AInitikesh/MapMirror/case/stl/fit_test_mount.stl

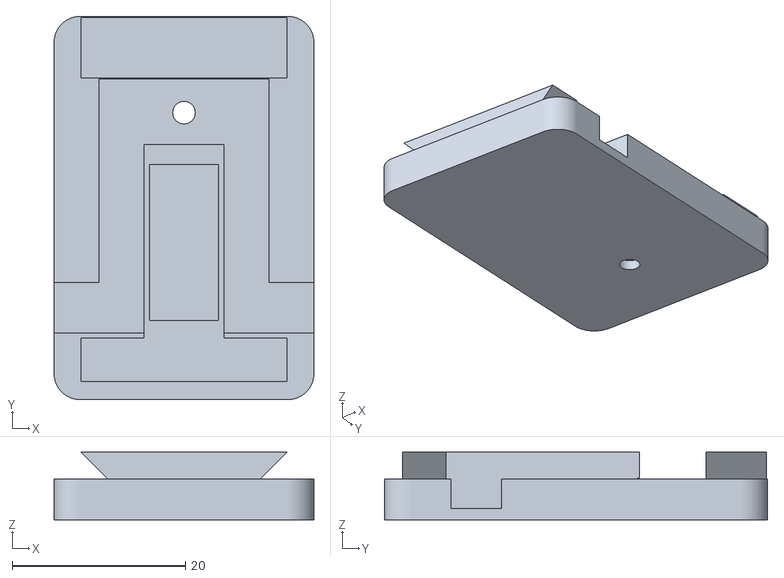
[picture p13: CAD file, 2026-11-09]
case/stl/fit_test_mount.stl
30.0 x 44.2 x 7.80
