AInitikesh/MapMirror/case/stl/mount_upper.stl

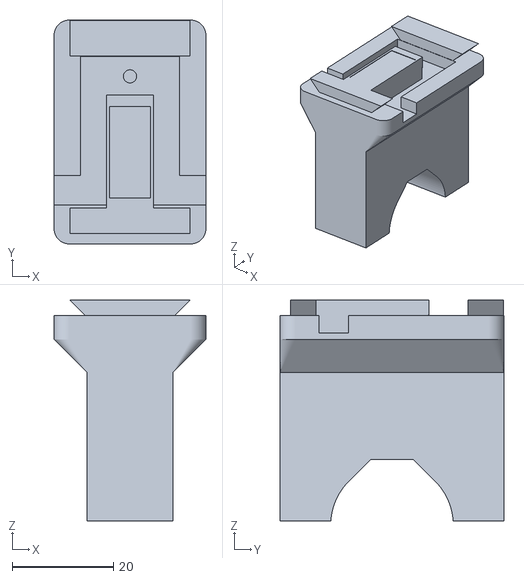
[picture p14: CAD file, 2026-11-09]
case/stl/mount_upper.stl
30.0 x 44.2 x 43.7
