AInitikesh/MapMirror/case/stl/mount_lower.stl

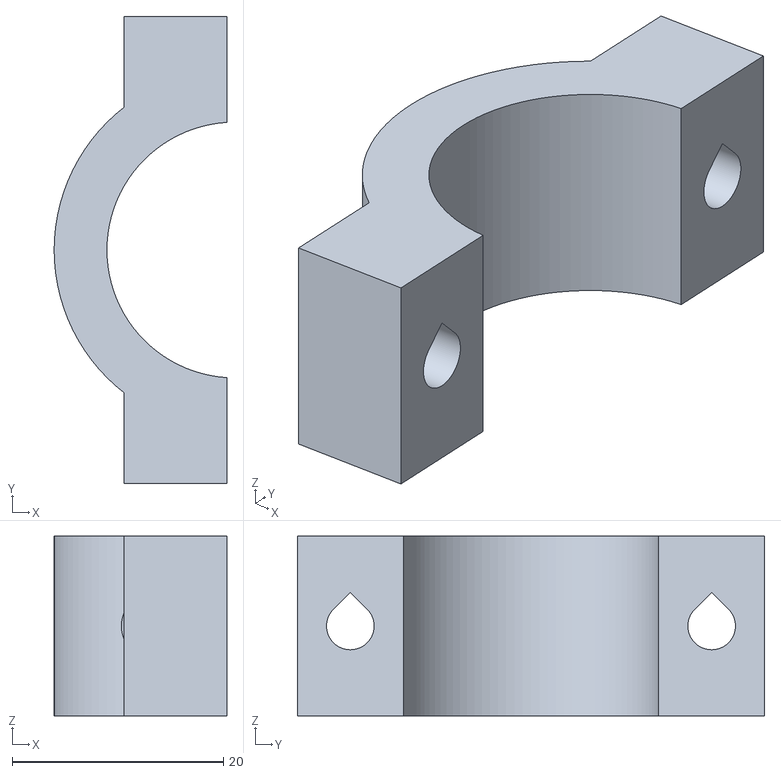
[picture p15: CAD file, 2026-11-09]
case/stl/mount_lower.stl
16.4 x 44.2 x 17.0
