AInitikesh/MapMirror/case/stl/box_lid.stl

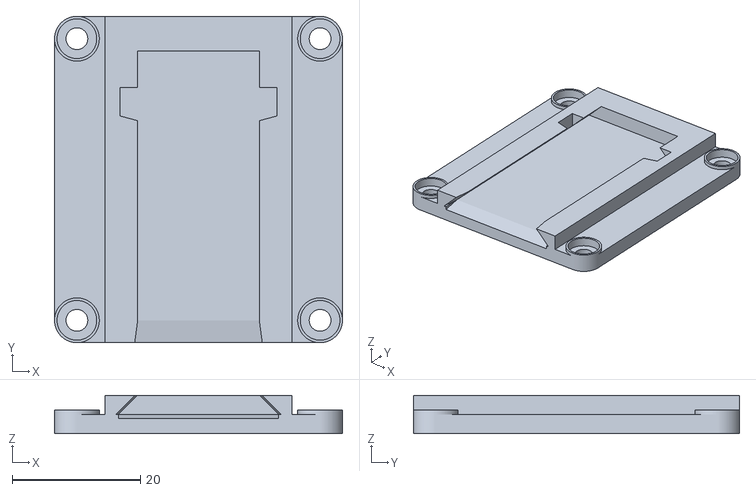
[picture p16: CAD file, 2026-11-07]
case/stl/box_lid.stl
45.0 x 51.0 x 6.00
