AInitikesh/MapMirror/case/stl/fit_test_bracket.stl

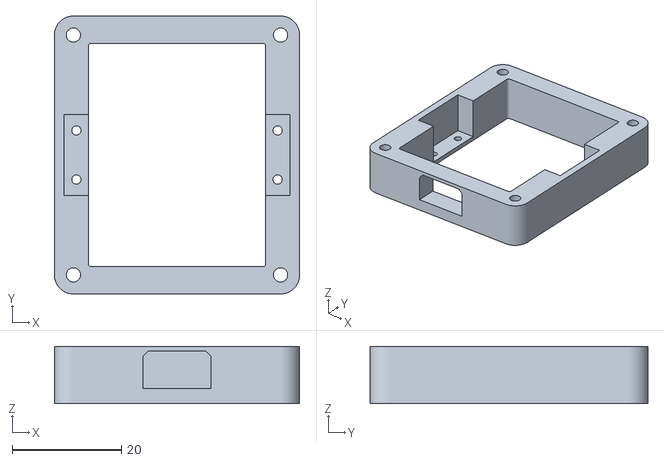
[picture p17: CAD file, 2026-11-07]
case/stl/fit_test_bracket.stl
45.0 x 51.0 x 10.5
