AInitikesh/MapMirror/case/stl/fit_test_front.stl

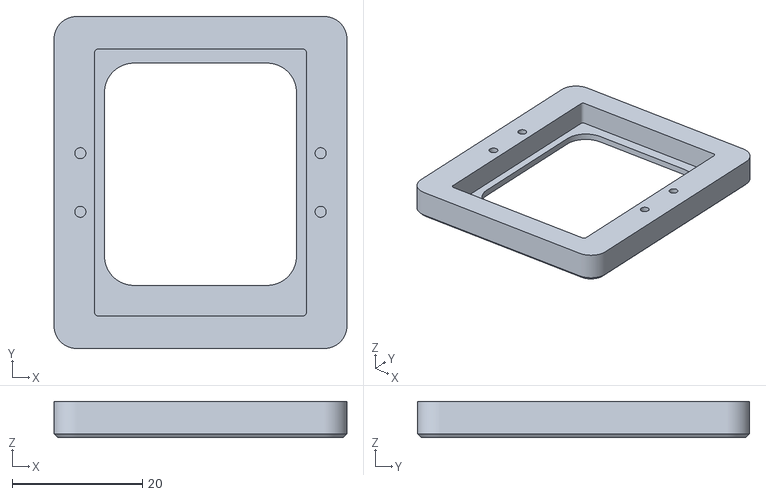
[picture p18: CAD file, 2026-11-07]
case/stl/fit_test_front.stl
45.0 x 51.0 x 5.60
