AInitikesh/MapMirror/case/stl/display_bracket.stl

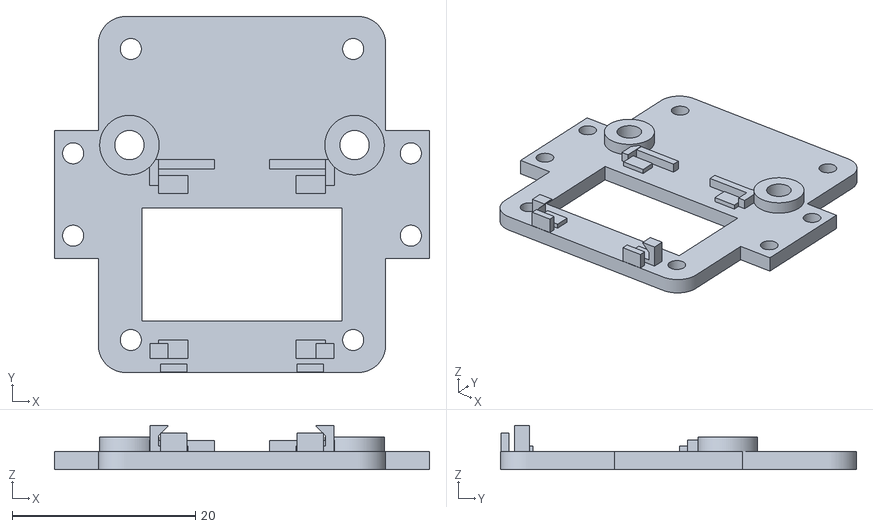
[picture p19: CAD file, 2026-11-07]
case/stl/display_bracket.stl
41.0 x 38.9 x 4.85
