AInitikesh/MapMirror/case/stl/latch.stl

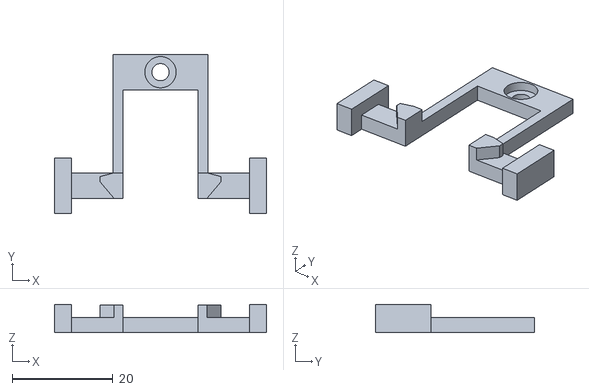
[picture p20: CAD file, 2026-11-07]
case/stl/latch.stl
42.0 x 31.5 x 5.60
