AInitikesh/MapMirror/case/stl/xiao_strap.stl

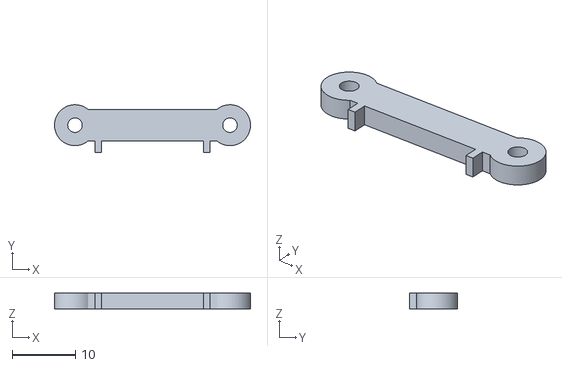
[picture p21: CAD file, 2026-11-07]
case/stl/xiao_strap.stl
31.1 x 7.55 x 2.50
