AInitikesh/MapMirror/case/stl/front_shell.stl

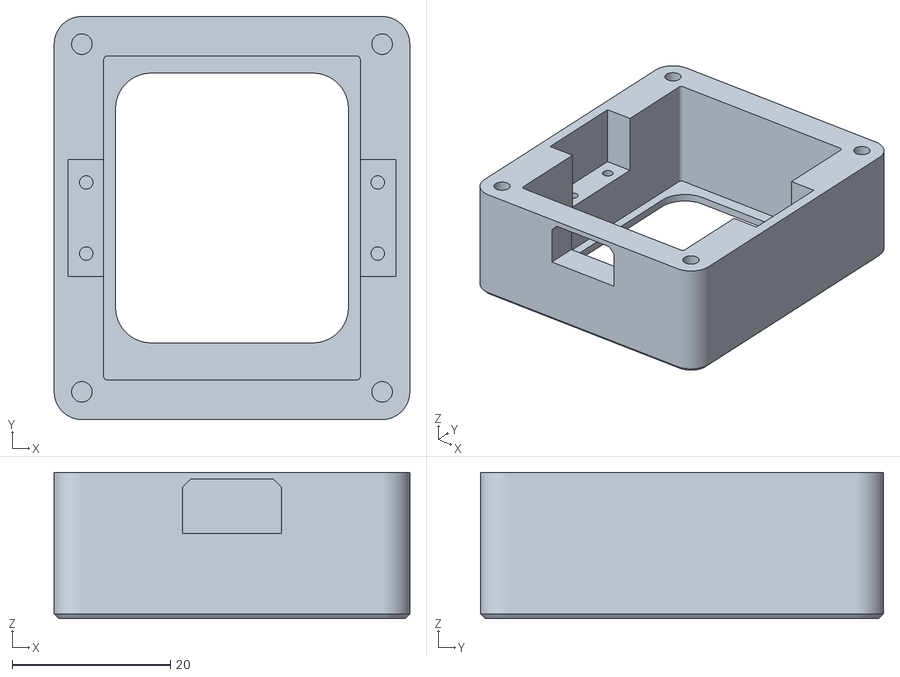
[picture p22: CAD file, 2026-11-07]
case/stl/front_shell.stl
45.0 x 51.0 x 18.5
