AInitikesh/MapMirror/(commit log)

2026-11-07 Add MapMirror: mirror your phone's screen to a handlebar display
    An Android app mirrors your phone's screen, such as your navigation app, to a
    240x280 ST7789 display driven by an ESP32, over Wi-Fi or Bluetooth LE. It can
    also run the navigation app on a private virtual display, so the phone stays
    free for other apps.
    - android/: the phone app. Each display's key is confirmed once with a code
    shown on both, then checked on every connection, and Wi-Fi frames are
    encrypted with AES-128-GCM.
    - firmware/: the ESP32 firmware, with a pairing window for new phones.
    - case/: a 3D printable, screwed-shut handlebar case with a quick release,
    generated and checked by build.py.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
    [box_lid.stl, display_bracket.stl, fit_test_bracket.stl, fit_test_front.stl, fit_test_mount.stl, front_shell.stl, latch.stl, mount_lower.stl]
2026-11-09 Fit the clip-on mount to a Karizma XMR, tap its screws, start the display service on Wi-Fi
    Case:
    - SIDE_H sets the switch block's height above the bar; the build sizes the
    upper mount's neck from it and checks the plate and box clear it.
    - Clamp narrowed from 22 to 17 mm to fit between the clutch and switch block.
    - Upper mount bolts and the latch screw tap into pilot holes, no inserts.
    App:
    - Starts the display service in the background while on Wi-Fi, after a
    restart too, so virtual display works at the bike without Wi-Fi.
    - Clear messages when there's no Wi-Fi to start it, or Android has
    forgotten the wireless debugging pairing.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
    [fit_test_mount.stl, mount_lower.stl, mount_upper.stl]
